ghztomash/fasma_drum/(threads)

Thread 1 (2019-01-23):

BOM issues

Knochi, 2019-01-23:
Hi,

currently I'm looking up the parts at my favorite dealer. The MPN for the upright audio jacks is missing. Got it from the schematic but they are difficult to order anyhow.
I would suggest to use the horizontal ones here as well, or at least make it an option by version or multipad (put pad layout for both parts one above the other).

ghztomash, 2019-12-11:
Hi, Thanks for the feedback, that's definitely a good idea.
I usually use the [Thonkiconn](https://www.thonk.co.uk/shop/3-5mm-jacks/) ones leftover from eurorack projects, but back then they didn't have the Stereo version.

Thread 2 (2019-12-05):

Cannot compile

walidvb, 2019-12-05:
Hey Tomahs, long time no speak :)

I'm getting the following errors when compiling:

- I've installed teensy and do have these libraries installed.
- I can't find anything online about `AudioExtended.h`?
- I cannot find any other files named `SD.h` or others, neither in `/Application/Arduino` or `~/Documents/Arduino/libraries` or anywhere, really..

Any clue or hints?

Thanks!

```
Multiple libraries were found for "Snooze.h"
 Used: /Applications/Arduino.app/Contents/Java/hardware/teensy/avr/libraries/Snooze
/Users/alinemartinez/Documents/Arduino/Drum_final_v12/Drum_final_v12.ino:36:27: fatal error: AudioExtended.h: No such file or directory
Multiple libraries were found for "Bounce.h"
 Used: /Applications/Arduino.app/Contents/Java/hardware/teensy/avr/libraries/Bounce
compilation terminated.
Multiple libraries were found for "Audio.h"
 Used: /Applications/Arduino.app/Contents/Java/hardware/teensy/avr/libraries/Audio
Multiple libraries were found for "SPI.h"
 Used: /Applications/Arduino.app/Contents/Java/hardware/teensy/avr/libraries/SPI
Multiple libraries were found for "SD.h"
 Used: /Applications/Arduino.app/Contents/Java/hardware/teensy/avr/libraries/SD
Multiple libraries were found for "SerialFlash.h"
 Used: /Applications/Arduino.app/Contents/Java/hardware/teensy/avr/libraries/SerialFlash
Error compiling for board Teensy 3.2 / 3.1.
```

ghztomash, 2019-12-11:
Hi,
Hmm seems like maybe you have them both installed through the Teensyduino and then from the Arduino manager? At least for the multiple libraries error.
For AudioExtended.h it's my bad I never got around to finish it for publishing..
For now you could flash with the compiled .hex file found in Drum_final_v12.zip

walidvb, 2019-12-11:
The installation was done remotely via skype, and that could be the case. Still, I wasn't able to find 2 instances of those libraries on @alinemartinez' computer.
Sometimes, the error would point to both paths(Used and Unused), and I was able to remove the duplicates, but not for all.

The goal of this exercise was to slightly modify your code to replace the knobs with wearables, and that required calibrating the input.

In any case, no fuss, we're working on another solution!

Thanks for your answer 🙏🏻
