ghztomash/fasma_drum/hardware/Fasma Drum Assembly.pdf

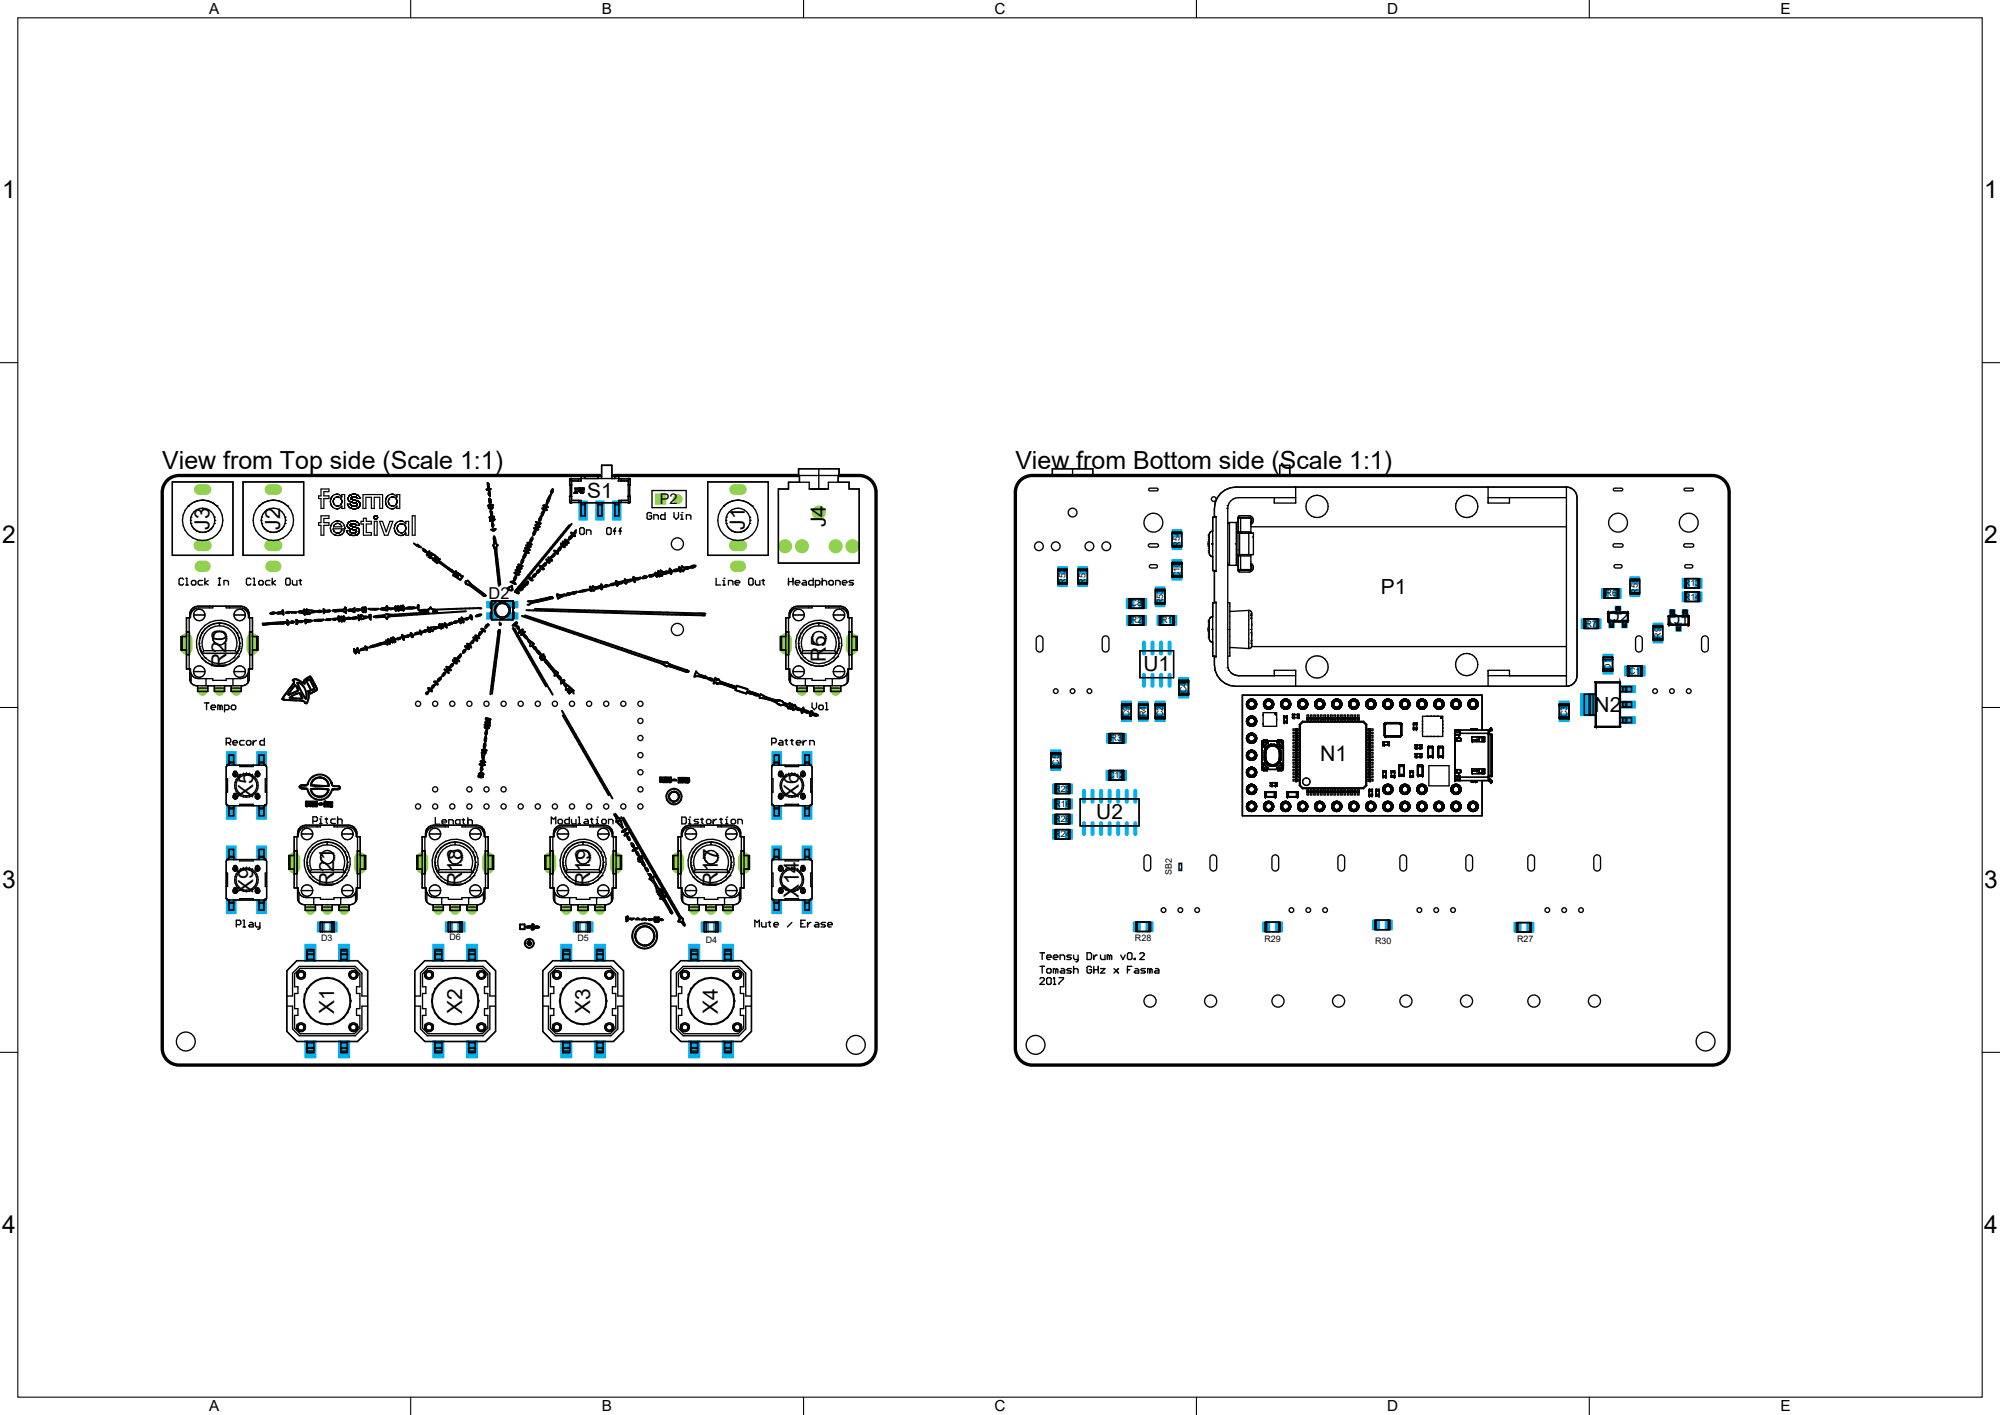
[picture p1: page 1]

View from Top side (Scale 1:1)

View from Bottom side (Scale 1:1)
