ghztomash/fasma_drum/hardware/Fasma Drum BOM.pdf

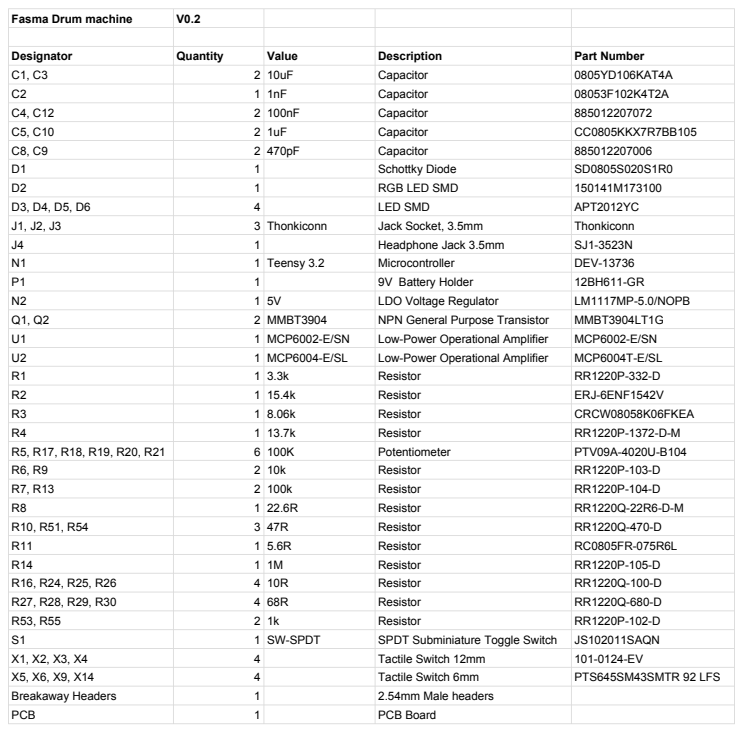
[picture p2: page 1]
