ghztomash/fasma_drum/hardware/Fasma Drum Schematics.PDF

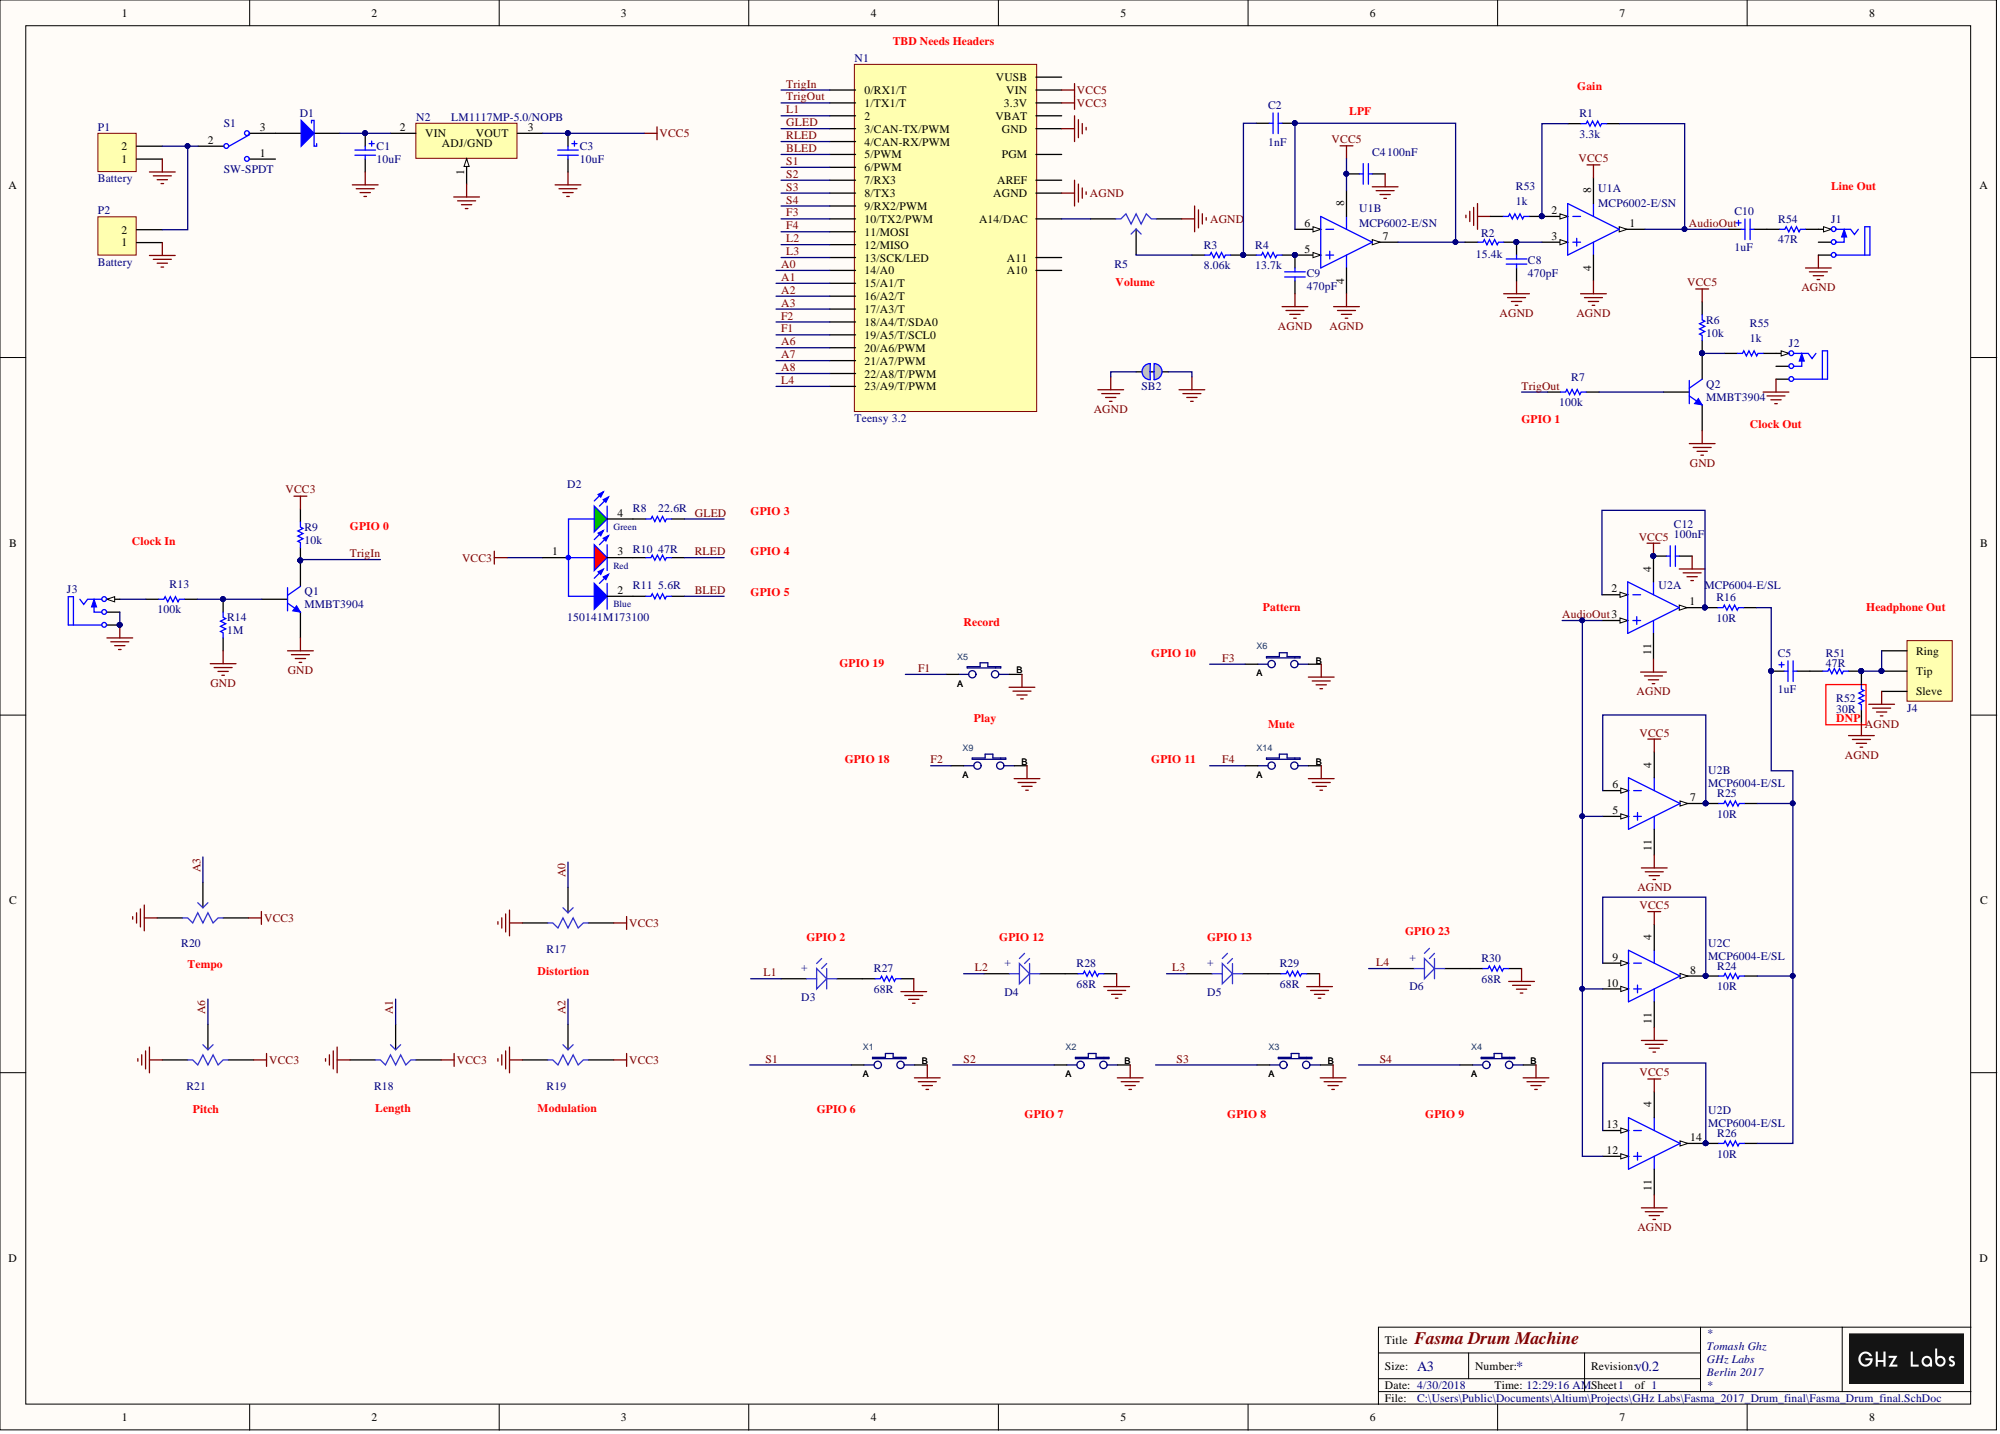
[picture p3: page 1]

Fasma Drum Machine Title | * Tomash Ghz GHz Labs Berlin 2017 *

Size: A3 | Number: * | Revision: v0.2
Date: 4/30/2018 Time: 12:29:16 AM | | Sheet 1 of 1

C:\Users\Public\Documents\Altium\Projects\GHz Labs\Fasma_2017_Drum_final\Fasma_Drum_final.SchDoc

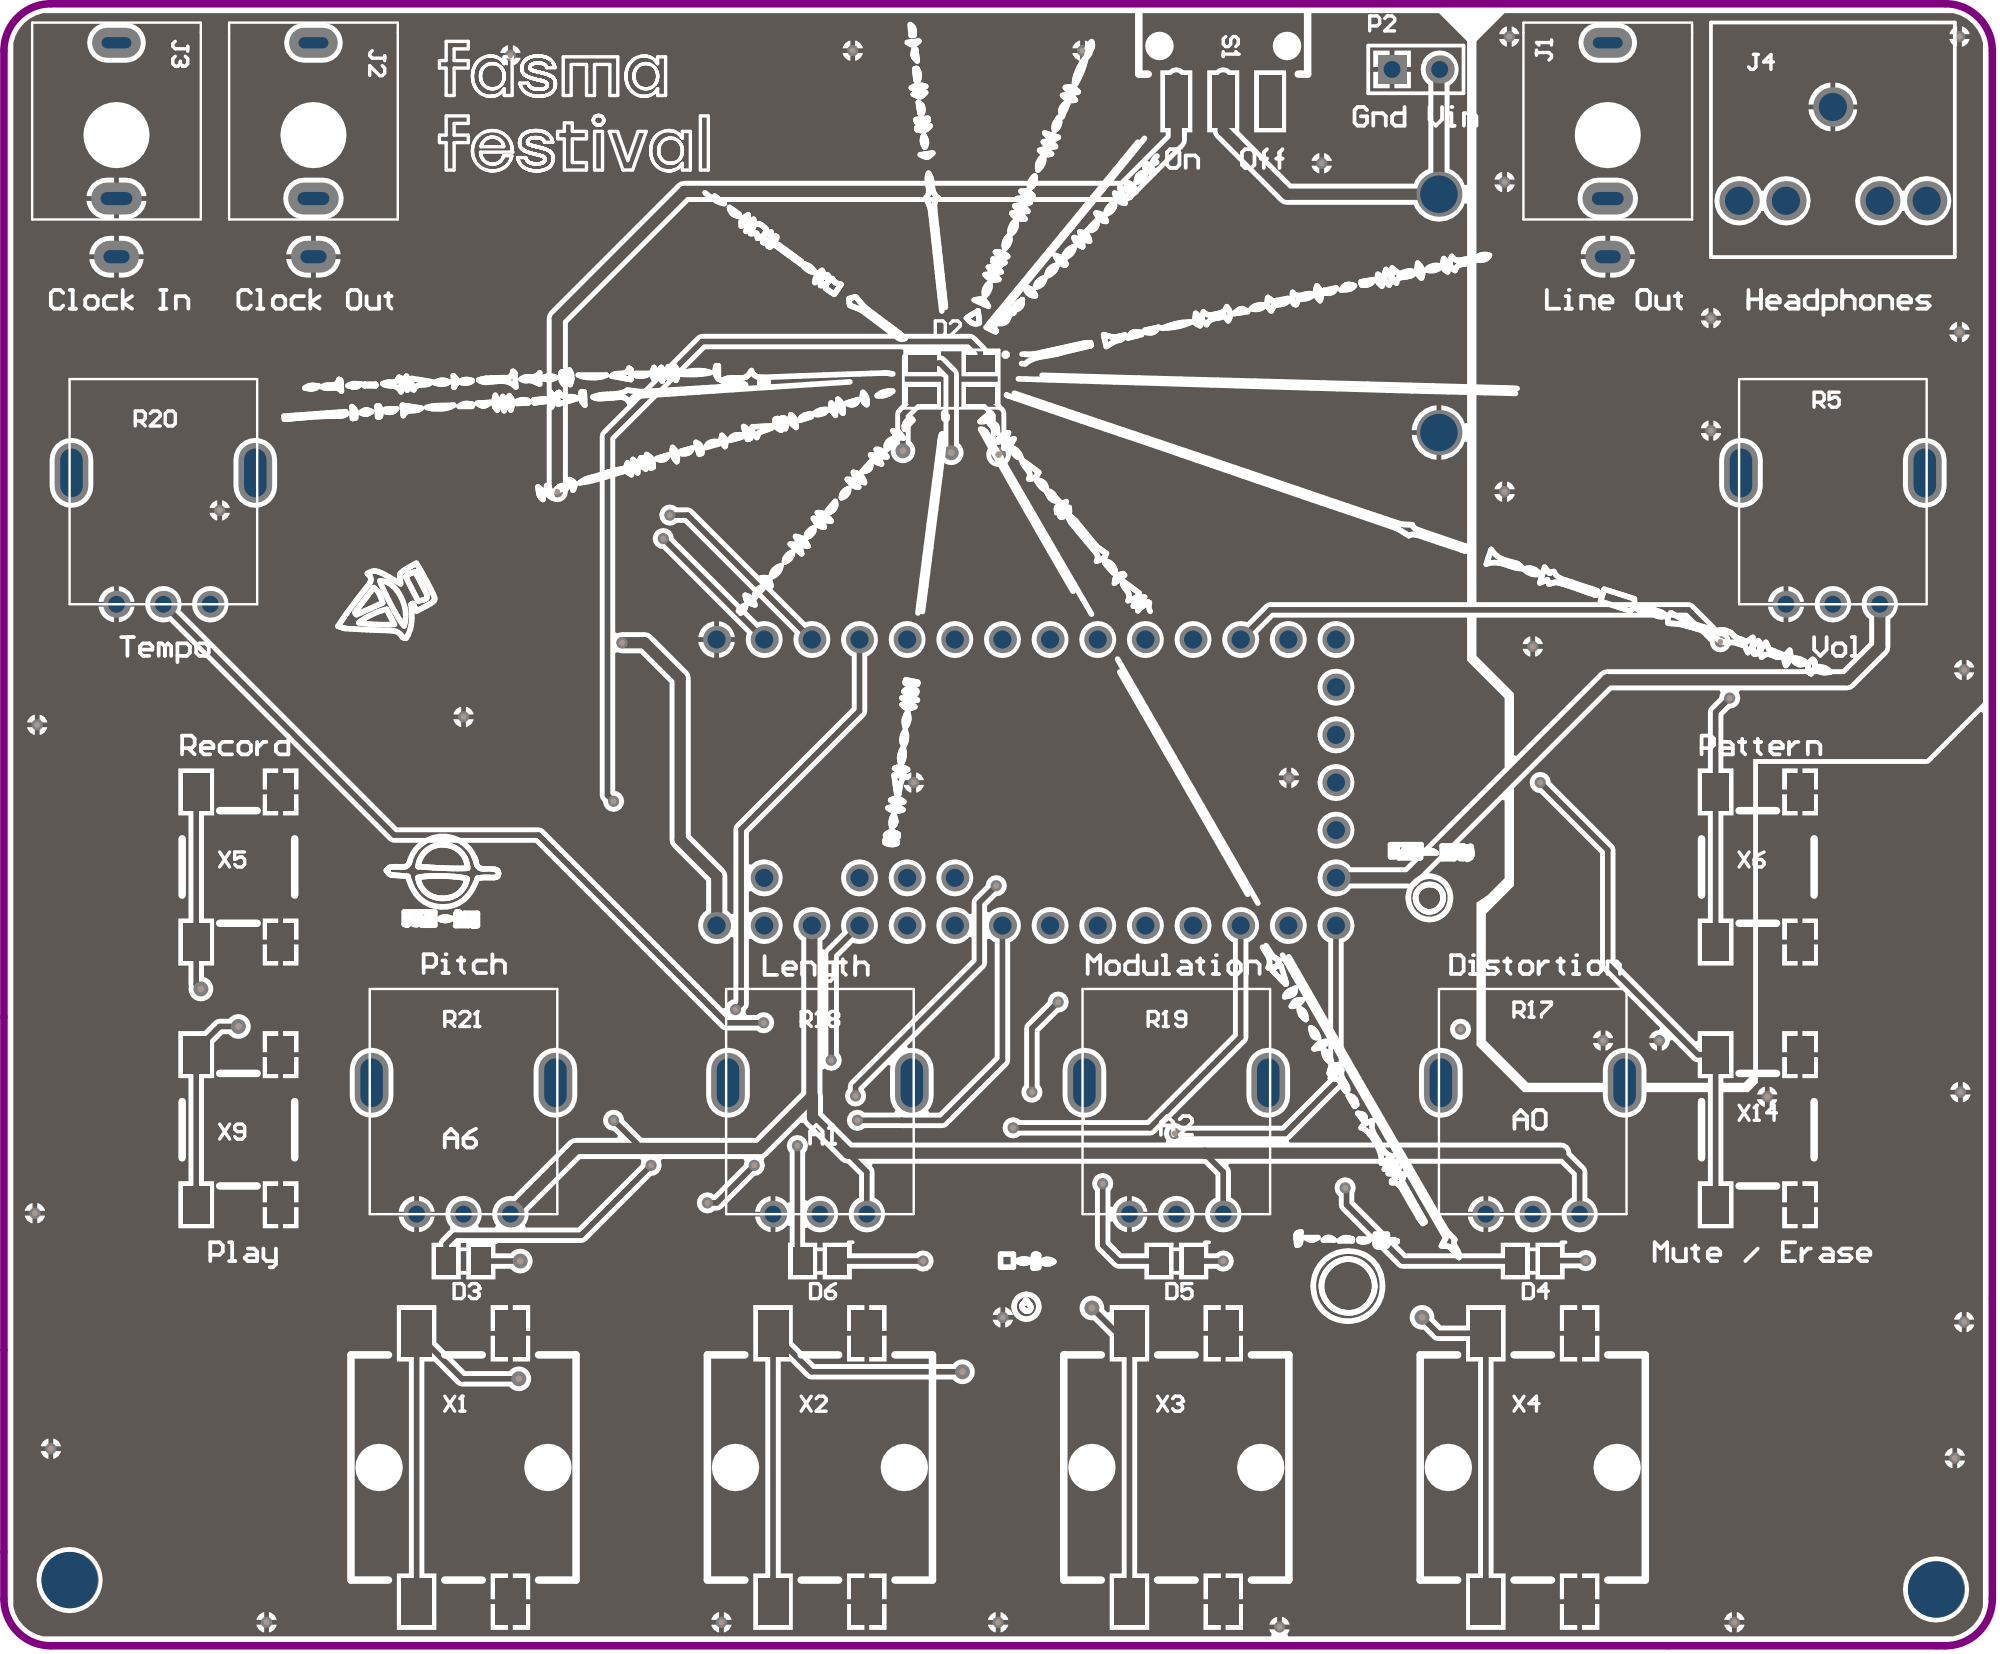
[picture p4: page 2]

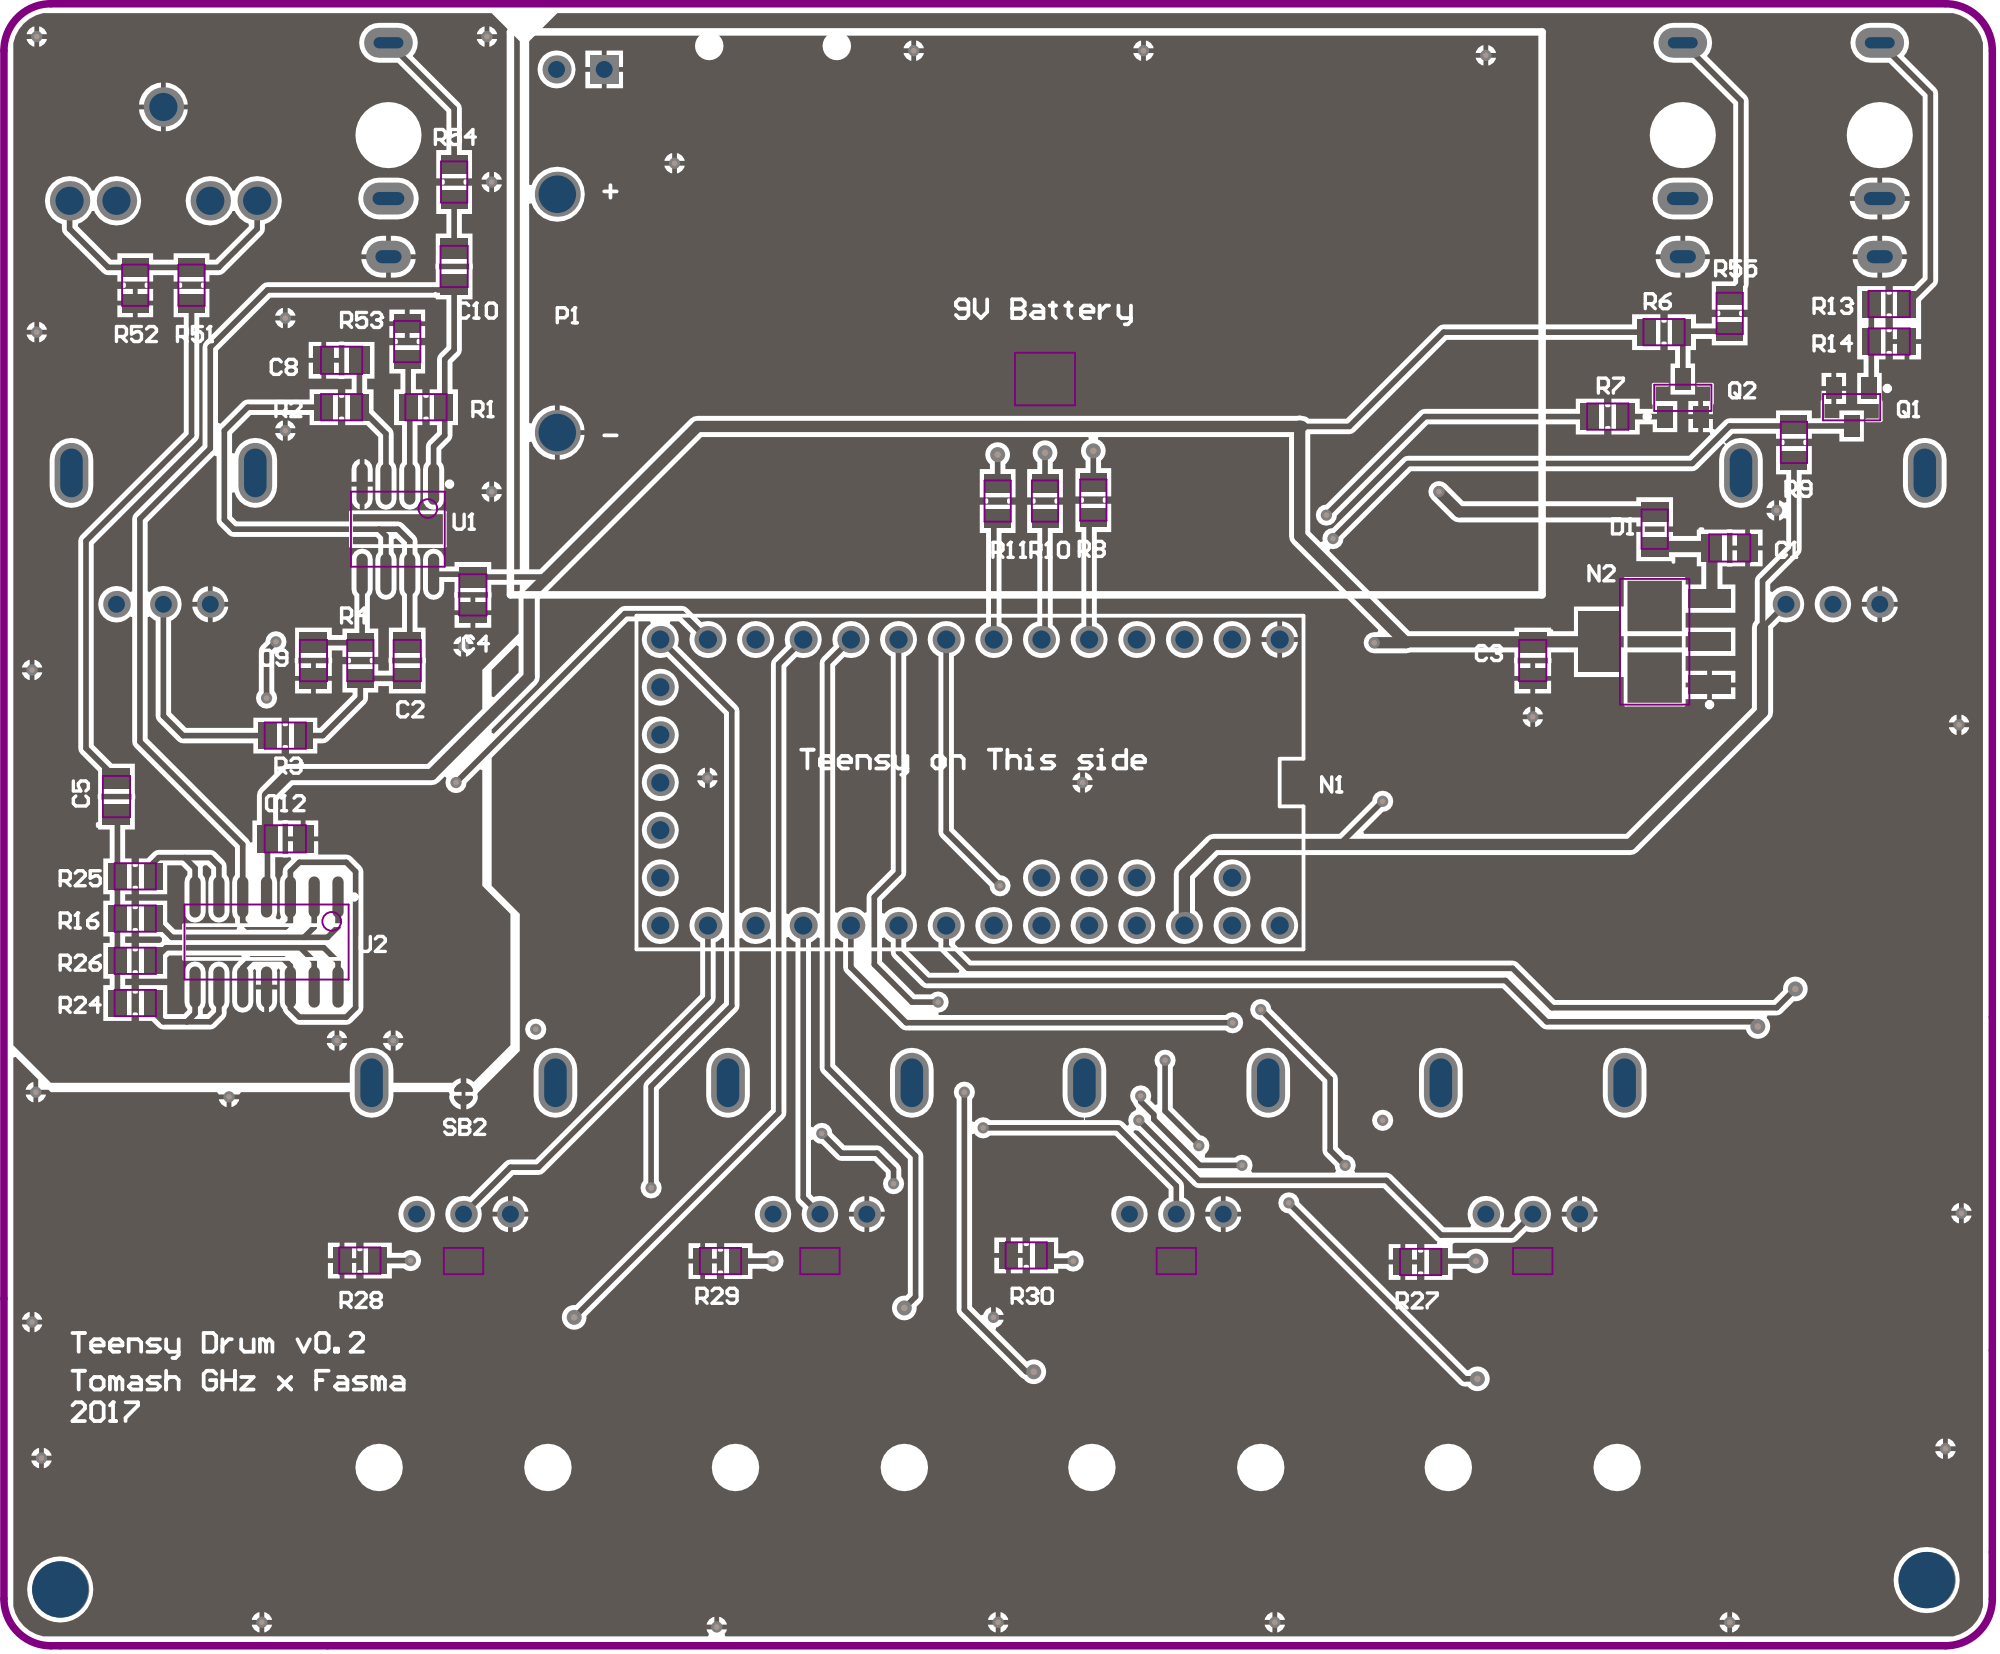
[picture p5: page 3]
