ghztomash/fasma_drum/firmware/AudioSampleHat1.cpp

// Audio data converted from WAV file by wav2sketch

#include "AudioSampleHat1.h"

// Converted from hat1.wav, using 44100 Hz, 16 bit PCM encoding
const unsigned int AudioSampleHat1[4417] = {
0x81002265,0x00000000,0x00090001,0xFFF3000E,0xFFF0FFD8,0xFFEAFFF9,0x003D0012,0x003F0053,
0xFF97FFD1,0x0056FFFE,0xFF18FFC1,0x008EFFBF,0xFEB9FF96,0x01F700B2,0xFFE2FFF4,0xFF660137,
0xFF5DFDE7,0x04570299,0xFF34029A,0xFA32FB5F,0x016DFC79,0xFDA50377,0x0788FDD6,0xFA830562,
0xF9F8F9A2,0x07EEFC10,0x050B0C2A,0x04EB0392,0xFB77FEB9,0xF155F9A7,0x0A4BF7A3,0xF6D0056C,
0x0F970240,0x048D0A55,0xE8AEF899,0x0328F12D,0x04F40248,0x13A717BA,0xE3ABEFAA,0xF705F5B9,
0x173DFCE3,0x015616B1,0x0170FEAE,0x0D7D0571,0xE96AFF60,0xF8C4E9AB,0x0C330A77,0x0BF603B5,
0xFEDE0D65,0xEA0AF3AF,0xF642EAAF,0x1DD90A0A,0xFBF81402,0x046AFBBA,0xE2A7F2BA,0x27FF02A2,
0xED16177C,0xFE9DE4E2,0x09501146,0xEFDBF8E0,0xE279E5FC,0x19B2F4CB,0x1C232C06,0xE82201BF,
0x0895EBBD,0xF5651196,0xFC79DDB2,0xEC44108F,0x3547EE54,0x027A4A10,0xF3B0DE0B,0xEC7CE69D,
0xFE6F093C,0x46C41F9C,0xBAAE05D5,0xF73BCE60,0xF281F617,0x042FE950,0x26763B43,0x15D0093A,
0xD55BF938,0x1971EB52,0xDF1E1DAA,0xF6FEC6CE,0x02EC036C,0x36A329F4,0xE51A0D2E,0x1E0FF2C7,
0xDDFD16C1,0xD811BDE5,0x1E870B82,0xFB7F0DB2,0x03F6FECE,0x1FA40AEF,0xCF3B0311,0x0A75DF95,
0x250E1AEA,0xED3F18FC,0x0299E01A,0x03901833,0xFF1DF131,0xF4AFFFAE,0xFC98FD5E,0xE1E8F3DA,
0x1344D0D4,0x34425CDC,0xDD4DED88,0xFA6FF26E,0x01E0F84E,0x0130FF39,0x18311103,0xD8D907FE,
0xF2A5CBC4,0x26A0130D,0x1B982C0E,0xEC2FF8AE,0xCE02E630,0x38DEFE55,0xEDDF0DE7,0xF88103B3,
0x07DAF128,0x145010C6,0xD9C90055,0x01E9E7BA,0xDDD1E53A,0x2A3B0F19,0xF4F50C90,0x22150CEC,
0x04E01A74,0xC304E13C,0xFDBACEA0,0x31512AF3,0x23E92308,0xC61BFC74,0x1181DBAF,0xEB9415B7,
0xEF4EE14A,0x115AED6A,0x23583978,0xEBF0FCCB,0x1977F736,0xD1F804ED,0x1DDEF7BB,0xF1F2FF1D,
0x10B9001F,0xE4C20B79,0xF9CAD899,0x0AFC092D,0xF7B70931,0x1CFB06DA,0xDB5F0561,0x0231C90D,
0x27DD4A5E,0x048CF4F0,0xF97A0C93,0xCD26D912,0x2B22F711,0x0A0B2964,0x235E1373,0xC030FDEC,
0xF2DBBD9A,0xF9ED022F,0x265C0C5E,0x10F82F78,0xD4DDE4F7,0xFEFFDD21,0x23311E42,0xE90A1338,
0xFA9ADA2D,0xFB26046B,0x0FF10F48,0x00E2F312,0xF51C1360,0x05AAE7B9,0x040810CD,0x0F9E04F9,
0xF0DE0895,0xF8C4ECC7,0x1420FFB2,0x17BD2BBA,0xC36BDE2D,0x0B5CE4BB,0xF27506A7,0x1B22FD4C,
0x333F3963,0xD664FD9B,0xC946C4E8,0x04F1DD1A,0x288F3CB3,0x26950045,0xE9192855,0xD17FC8C9,
0x1D6DFAD9,0xFFD823F2,0xEC2FCE81,0x2CC22334,0xEDB41C53,0xF0B4CDF1,0x11B716C7,0xE50CF3DF,
0x12FE00DF,0xF8A8041D,0xFE32F71D,0x10BB0FB9,0xE1CEF442,0x16F3ECD7,0x332444D2,0xCEB4F69A,
0xFD8CD686,0xC9AAEC9A,0x31370842,0x114CFDC1,0xFEEB39C4,0xF54DDFB0,0xF8B2F826,0xF385F0EC,
0x172B1094,0x046C02C6,0x0AFC173D,0xD118E206,0x0490E3BD,0x4B4B364B,0xC0390DAB,0xFC9FCB18,
0xDFA3E762,0x60753859,0xC06E02B2,0x1796F66F,0xEE17FC5B,0xF9EDEFF6,0x415713B5,0xD97831E7,
0xC74FAB9C,0x261603F1,0x063F0A4A,0x1D4434EE,0xCD07D69E,0xF8CBE0A8,0x0AFA13FD,0x1C6EFFB4,
0x0FDD2E27,0xC8C1DF7D,0x0845E281,0x1D5A1378,0x199131D4,0xD8BCDF42,0x05E0F2E0,0xFA4710F6,
0xF49DE055,0x28501FFF,0xF1250A36,0xEA80ED20,0x0611EC8F,0xF0080427,0x1E860C2A,0xFB14087F,
0x067FFA5D,0x11E41B48,0xB9DCDC7A,0x15A7DDBF,0x2F8A2DCF,0xF7481DEF,0xED1CDD10,0xEA09F97E,
0x1D12F7CF,0x0E5C2ADA,0xD506E382,0xE69ACD63,0x43352BDA,0x01EB279C,0xDB00DDFE,0x0799EF29,
0xFC480E01,0x1A860284,0x13222188,0xD098EFD7,0xF320CEAD,0x46C138C5,0xC825FC1B,0xFF81DA45,
0x172117FB,0xD6C7EE90,0x19ABFC96,0xE4C602DB,0x105BEB3C,0x27E52B55,0xFF7D1723,0xE442EA73,
0xF350E80F,0x11E2FEED,0x1E172360,0xE3D606B7,0xDB95CE8C,0x30F6FFDB,0xE8AE37A8,0xEE00B018,
0x3C5B3E48,0xE15112A5,0xDAA2B581,0x2E223601,0xF928E721,0x0C912571,0xF30BECDE,0xEAA7F6F1,
0xFD19EA24,0xF9B7054D,0x19D00285,0x1CE42996,0xCA44E6DB,0x001BD768,0x2D5D37CE,0xE0ADE5F7,
0x28D520F6,0xEEEE0822,0xC5CCCC04,0x3823F5F6,0xED2933F0,0x082DDCF8,0xF7D1116A,0x029BF2F5,
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
};
