ghztomash/fasma_drum/firmware/AudioSampleSnare2.cpp

// Audio data converted from WAV file by wav2sketch

#include "AudioSampleSnare2.h"

// Converted from snare2.wav, using 44100 Hz, 16 bit PCM encoding
const unsigned int AudioSampleSnare2[4673] = {
0x81002471,0x00010000,0x00020002,0xFFF8FFFF,0xFFACFFEF,0xFFDBFF91,0xFFC4FFE8,0xFFDCFFA3,
0x00810062,0x0027002A,0x01450101,0x00A200C8,0x03070185,0x00B90316,0xFE64FE9A,0xFB3BFD49,
0x010BFCB5,0xFD1A0084,0x02F9FDA6,0x06490811,0xFD9E00B0,0x0077FE9C,0xFDE80035,0xFD0AFC3E,
0xFDB0FD5B,0xFC4EFE2B,0x03CAFCD8,0x0526092B,0xF3F7FB8E,0x0053F53C,0xFFA6062F,0x0150FBF1,
0x084B081E,0xF5C3FF78,0xF9ADF4C1,0x05BEFF3B,0x05B9073C,0xF30B007C,0x033AF01A,0x0B9E1411,
0xF6AEFB9E,0x11FEFF5B,0x11FA1AAD,0xF734029F,0xFB27F6F8,0xE816F0DF,0x1758021A,0xFC4609F3,
0xF59AFAFD,0xF23CE9CF,0x0AD001D6,0x270C1AF7,0x16E8262A,0x0AF30770,0x1D6F1BA8,0xF4F704E1,
0x137C00EC,0x2F5623F4,0x05E52635,0x00C4F11B,0xFCF30E9F,0x0591F57B,0x07080B6B,0x01FA0002,
0x06F80A3D,0xF2A9FB9B,0x21D402B2,0xE26716E6,0xD1D7C0FC,0x26BB03B1,0x17242723,0x10C60EF0,
0x073B0FB8,0xFCE7F951,0xFEF701CC,0x04B1047E,0xEFB0FD1A,0xD1EADFAE,0xC352CABD,0xBEDFBB0D,
0xD475CAA3,0xDFB2DAE0,0xDC0EE0E5,0xD669D799,0xD913D6DE,0xDEF6DB68,0xE341E172,0xE6C7E52A,
0xEB7AE804,0xF5E2F32C,0xF3C6F46C,0xF60CF290,0xF70FF9D4,0xEE31F11B,0x27660608,0x0567223D,
0x0F44FBA2,0x21A623DE,0x064710D2,0x0E5607BB,0xFE8E0AEF,0x144A038F,0x18A31ADB,0x108415B7,
0x1A701014,0x14961E33,0x09590AEF,0x19A2121E,0x148619A0,0x024F06D8,0x10E30B6C,0x11B511B6,
0x128E1232,0x12DD12C8,0x12FC12CD,0x133F1300,0x1887170F,0x01CC0D8E,0xF991F8E4,0x13110B3E,
0x113C10F3,0x00BD0ADD,0xFF84FBD7,0xFCE50192,0xFEE6FBAA,0x0A030527,0xEC3DFDBA,0x1C26F63D,
0x1CB4301D,0x0D2D096C,0x05A6149C,0x01C2F303,0x3BEA2555,0x0B3D2FA3,0x0B56FA3B,0x2C3D22DC,
0x17B225E2,0x0AC70E2E,0x00F6053B,0x05E8052C,0xF245FAFF,0xED5BF1F8,0xD5EDDDB6,0xE61EDC17,
0xFE6AF693,0xE5BAF57D,0xDE46DB4E,0xCEB8DC98,0xBAECBFA9,0xB969BF1B,0xAFCAA931,0xE3BDCF94,
0xD5AFE3CB,0xB89FC392,0xCF39BFCA,0xC06ECD51,0xC5A1BCBB,0xCF71CE9A,0xE40ED2F6,0xEE96F5CC,
0xC31CD16C,0xF363D241,0xFD9F0849,0xEA3DEBD5,0x0841F9E2,0xFDB60526,0x0EC20258,0x0C87158D,
0x1397033B,0x183C251E,0x091604A4,0x249C1C88,0x42AA2C7A,0x32B347D9,0x0242144C,0x2E5F14A2,
0x363C36F5,0x2F022ED1,0x3F4437FE,0x45A046E7,0x1DD53070,0x2D6D20EB,0x2B553101,0x36842B76,
0x4A6441CA,0x5D3855DC,0x369C521D,0x2BE427E7,0x26752C7D,0x1CEB207C,0x1FEB1E87,0x170F1B7E,
0x0E4C13AA,0x0F940A80,0x146B174B,0x09BA0D1C,0xFA7B03EF,0xF489F546,0xF1FDF3A2,0xF1DBEFB4,
0xFA5DF9E4,0xEE1AF237,0xEF97EE65,0xEBE7EE9B,0xEB85E953,0xFCF4F7E3,0xE996F222,0xEB28E843,
0xEBDEEE67,0xE8BFE866,0xF6B6F0EF,0xE078F0B0,0xD3F6D135,0xF1D2E219,0xFDDBFA39,0xDE53F7B4,
0xBA74C539,0xD451C1F6,0xEF13E653,0xBA20DBE6,0xD4BBB8E5,0xD49CE1F0,0xCAD8C59D,0xCF3DD2C5,
0xCB66C986,0xCDD4D114,0xDF1DD170,0xC7AED9AB,0xCB78C12C,0xEB08DF42,0xF805EDF8,0x0F7E0A59,
0xEC3AFECE,0x0B02F196,0x1C901E70,0x088F0B51,0x24401906,0x0CAB1D62,0x196D0B8B,0x22C6219A,
0x205D21C4,0x1DF81F55,0x193B1B51,0x1911196B,0x16C817D2,0x0FD614D8,0x0CA20BBC,0x07D50C3F,
0x1AA20ADB,0x1A4622CC,0x024B0BF9,0x1A8A0870,0x20D424D6,0x1891196E,0x30F8250F,0x24252EAB,
0x2A461EB1,0x3F483A21,0x314C3B69,0x259927BC,0x26572567,0x219127A8,0x0C2C1606,0x0389071C,
0x1A8B0AC1,0x17101D25,0x0AA70EC5,0x18FB1148,0x24391F28,0xFDC01AE5,0xE799E8B0,0xFAEDEEF4,
0xF2DCFD0D,0xEE6BEDE8,0xF7BCF274,0xFB86FA71,0xE60FF174,0xEC9BE8C8,0xDC00E3F7,0xD938DB72,
0xE4C0DCEE,0xDA83E595,0xDC12CFCB,0xF4A1F2AD,0xCB3FDE0E,0xB991C1BE,0xD7E0C6B8,0xB0C3CA8A,
0xB8F6A9CC,0xCA1DC715,0xCE1DC877,0xDD41DC60,0xCABAD2F5,0xC3EFC2D0,0xF30FDB38,0xD0B7EDF6,
0xC2A1B7C2,0x048AEB76,0xF1FDFDE8,0xF116EE7B,0xEDFEF277,0x0438EF6D,0x0D8616FC,0xEEC4F727,
0x16430064,0x15881C34,0x07C40E02,0xFE6FFDD1,0x107D082A,0x04040F1B,0x0505FDE7,0x18B514B6,
0x05D60C47,0x205D1432,0x02BC1353,0x1AAB0915,0x1A0C202F,0x0E2710C6,0x0F400EE0,0x24791992,
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
};
